puxinmao/ascend310b-object-tracking/中期检查报告.md

# 目标跟踪检测系统 — 中期检查报告

**项目名称**：基于昇腾 310B 与 STM32 的目标跟踪检测系统  
**检查日期**：2026-07-06  
**文档版本**：V1.0  
**提交小组**：第二组（哈基米南北绿豆）  

---

## 一、物料到位总览

### 1.1 已到位物料清单

| 序号 | 物料名称 | 规格/型号 | 数量 | 状态 | 用途 |
|:---:|:---|:---|:---:|:---:|:---|
| 1 | 昇腾 310B 开发板 | Atlas 200 DK | 1 | ✅ 已到位 | 核心算力平台，运行人物检测算法 |
| 2 | 摄像头 | USB 摄像头 | 1 | ✅ 已到位 | 图像采集 |
| 3 | 舵机 | SG90 / MG996R | 2 | ✅ 已到位 | 控制摄像头水平（Pan）和垂直（Tilt）转动 |
| 4 | STM32F103C8T6 | 最小系统板 | 1 | ✅ 已到位 | 舵机控制 MCU |
| 5 | ST-Link 调试器 | V2 版本 | 1 | ✅ 已到位 | STM32 程序烧录与调试 |
| 6 | USB 转 TTL 模块 | CH340G | 1 | ✅ 已到位 | 昇腾与 STM32 串口通信 |
| 7 | 云台支架 | 二自由度云台 | 1 | ✅ 已到位 | 承载摄像头，水平+垂直双轴 |
| 8 | 面包板 + 杜邦线 | 若干 | 1 套 | ✅ 已到位 | 电路连接 |
| 9 | 外部 5V 电源 | 适配器 / 充电宝 | 1 | ✅ 已到位 | 舵机独立供电 |

### 1.2 未到货物料

所有物料均已到位，暂无未到货物项。

---

## 二、当前完成进度

### 2.1 已完成工作

| 序号 | 工作项 | 完成日期 | 说明 |
|:---:|:---|:---:|:---|
| 1 | 物料采购与核对 | 前期 | 全部物料到位并核对完毕 |
| 2 | 昇腾 310B 开发板环境搭建 | 前期 | 开发板上电运行，操作系统 / 开发环境就绪 |
| 3 | 摄像头图像采集 | 前期 | 摄像头连接昇腾成功，能实时获取画面 |
| 4 | 昇腾端人物位置检测与串口输出 | 前期 | 能检测人物在画面中的水平位置，通过串口输出 0x00~0xB4（对应 0°~180°） |
| 5 | STM32 PWM 舵机驱动 | 前期 | STM32 输出 50Hz PWM 信号，成功控制舵机 0°~180° 范围旋转 |
| 6 | STM32 串口中断接收（环形缓冲区） | 前期 | 使用 UART 中断 + 环形缓冲区，稳定接收昇腾端实时数据 |
| 7 | 昇腾 ↔ STM32 串口联调 | 中期 | 两者串口通信调试通过，数据可稳定传输 |
| 8 | 闭环跟踪功能（水平方向） | ✅ **已完成** | 人物水平移动时舵机自动跟随，使人物始终位于画面中央 |
| 9 | 闭环跟踪功能（垂直方向） | ✅ **已完成** | 人物垂直移动时舵机自动跟随，实现二维云台跟踪 |
| 10 | 二维云台联调 | ✅ **已完成** | 水平+垂直两轴协同工作，全方向稳定跟踪 |

### 2.2 进行中工作

| 序号 | 工作项 | 当前状态 | 计划完成 |
|:---:|:---|:---|:---:|
| 1 | 跟踪参数微调 | 对两轴 P 控制参数进行最终优化中 | 验收前 |
| 2 | 系统全面测试 | 不同角度，宽度和距离下的跟踪效果测试 | 验收前 |

### 2.3 未开始工作

当前核心功能已实现，暂无未开始的关键工作项。

---

## 三、硬件调试情况

### 3.1 硬件接线方案

```
                          ┌─────────────────────┐
                          │    外部 5V 电源       │
                          │  (舵机独立供电)        │
                          └──────────┬──────────┘
                                     │
    ┌──────────┐      ┌──────────┐   │  +5V
    │ 昇腾 310B │ USB  │ USB-TTL  │───┤
    │  + 摄像头  │ ←──→│  CH340   │   │  GND ──────┐
    │          │      │ TXD→PA10 │   │            │
    └──────────┘      │ GND──GND │   │            │
                      └──────────┘   │            │
                                     │            │
                              ┌──────▼────┐      │
                              │ STM32F103 │      │
                              │ C8T6      │      │
                              │           │      │
                              │ PA0 ──── 舵机 1（水平 Pan）   │
                              │ PA1 ──── 舵机 2（垂直 Tilt） │
                              │ GND ──────┼──────┘
                              └───────────┘
                                     │
                              ┌──────┬──────┐
                              │ 舵机1 │ 舵机2│
                              │ 水平  │ 垂直 │
                              │ Pan   │ Tilt │
                              └──────┴──────┘
```

**引脚分配表：**

| STM32 引脚 | 功能 | 连接目标 |
|:---|:----|:---|
| PA10 | USART1_RX | USB-TTL TXD（昇腾数据接收） |
| PA9 | USART1_TX | USB-TTL RXD（调试输出，可选） |
| PA0 | TIM2_CH1 PWM | 舵机 1 信号线（水平 Pan） |
| PA1 | TIM2_CH2 PWM | 舵机 2 信号线（垂直 Tilt） |
| GND | 共地 | USB-TTL GND + 舵机电源 GND |

### 3.2 STM32 外设配置

| 外设 | 配置参数 |
|:---|:---|
| RCC | HSE 8MHz → PLL ×9 → SYSCLK = 72MHz |
| USART1 | 115200-8-N-1，RXNE 中断接收 |
| TIM2 | CH1 (PA0): 水平舵机 PWM；CH2 (PA1): 垂直舵机 PWM；50Hz，脉宽 500~2500μs |

### 3.3 调试中遇到的问题与解决措施

#### 问题 1：串口接收响应慢（手动调试时）

- **现象**：PC 串口助手发送数据，舵机等待数秒才开始响应
- **原因**：回调函数中直接读 USART DR 寄存器，HAL 库在进入回调前已读走数据，导致读到无效值
- **解决措施**：改用固定缓存 `rx_byte` 配合 `HAL_UART_Receive_IT()`，回调中从缓存读取，响应恢复正常

#### 问题 2：与昇腾联调时舵机来回摆动

- **现象**：人物在画面最左侧时，舵机向右转→人物回到中央→昇腾发 0x5A→控制逻辑误认为"目标 90°"又重新回位→来回振荡
- **原因**：测试模式下使用"串口值 = 舵机角度"的直接映射，而昇腾发来的是"人物在画面中的位置"，两者含义不同
- **解决措施**：切换为跟踪模式（误差控制），计算 `误差 = 人物位置 - 画面中央`，误差为 0 时舵机保持不动

#### 问题 3：昇腾与 STM32 坐标系不一致

- **现象**：人物在画面左侧时舵机反而向右转，跟踪方向完全相反
- **原因**：昇腾端的坐标系定义与 STM32 端预期方向不一致
- **解决措施**：在 `Control_Compute` 中将误差取反，匹配昇腾坐标系方向（`adjustment = -KP * error`），跟踪方向恢复正常

---

## 四、软件调试情况

### 4.1 昇腾 310B 端功能

| 功能模块 | 开发进度 | 说明 |
|:---|:---:|:----|
| 摄像头图像采集 | ✅ 已完成 | 实时获取视频帧 |
| 人物目标检测 | ✅ 已完成 | 检测画面中人物的水平位置和垂直位置 |
| 位置 → 串口值映射 | ✅ 已完成 | 映射关系：0x00~0xB4 对应 0°~180°，字节值即角度值 |
| 串口数据发送 | ✅ 已完成 | 通过 UART 将位置值发送至 STM32 |

### 4.2 STM32 端功能

| 功能模块 | 开发进度 | 说明 |
|:---|:---:|:----|
| 系统时钟初始化（72MHz） | ✅ 已完成 | HSE+PLL 配置 |
| USART1 中断接收 | ✅ 已完成 | 环形缓冲区，接收中断触发 |
| TIM2 PWM 输出 | ✅ 已完成 | 50Hz，500~2500μs |
| 舵机控制函数 | ✅ 已完成 | `Servo_SetPulse` / `Servo_PulseToAngle` |
| 跟踪控制算法 | ✅ 已完成 | P 控制 + 死区 ±2° + 步进限幅 ±15° |
| 测试模式（PC 串口调试） | ✅ 已完成 | 发多少转多少，一步到位 |
| 跟踪模式（接昇腾使用） | ✅ 已完成 | 误差驱动，自动追人 |
| 模式切换 | ✅ 已完成 | 通过宏 `MODE_SERIAL_TEST` 一键切换 |

### 4.3 核心控制算法

```c
/* 误差 = 人物位置 - 画面中央(90°) */
float error = target_angle - SERVO_CENTER_ANGLE;

/* 死区：误差小于 2° 不动作，防抖动 */
if (fabsf(error) > DEADBAND_ANGLE)
{
    float adjustment = KP * error;                  /* 比例控制 */
    if (adjustment >  MAX_STEP_ANGLE)  adjustment =  MAX_STEP_ANGLE;  /* 限幅 */
    if (adjustment < -MAX_STEP_ANGLE)  adjustment = -MAX_STEP_ANGLE;

    float new_angle = current_angle + adjustment;   /* 更新角度 */
    uint16_t new_pulse = 500 + new_angle * 2000/180; /* 角度 → 脉宽 */
    Servo_SetPulse(new_pulse);
}
/* 误差 < 2°：舵机保持不动 → 人物在画面中央 → 系统稳定 */
```

### 4.4 已通过的测试用例

| 测试用例 | 测试方法 | 结果 |
|:---|:---|:---:|
| 舵机全量程测试 | PC 串口助手发送 0x00~0xB4，观察舵机 0°~180° 旋转 | ✅ 通过 |
| 串口数据接收 | PC 连续发送数据，STM32 环形缓冲区无丢包 | ✅ 通过 |
| 昇腾→STM32 通信 | 昇腾串口直连 STM32，数据传输稳定 | ✅ 通过 |
| 跟踪方向正确性 | 人物左右移动，舵机跟随方向正确 | ✅ 通过（修正后）|
| 人物静止时稳定性 | 人物在摄像头前静止，舵机无异常摆动 | ✅ 通过 |
| 人物水平走动跟踪 | 人物在画面内左右走动，舵机平滑跟随 | ✅ 通过 |
| 人物垂直移动跟踪 | 人物上下移动时，垂直舵机正常跟随 | ✅ 通过 |
| 二维联合跟踪 | 人物对角线方向移动，两轴协同工作 | ✅ 通过 |

---

## 五、存在的问题与风险

### 5.1 当前问题

| 问题 | 描述 | 影响 | 应对方案 |
|:----|:----|:----|:---|
| 水平/垂直参数未独立标定 | 两轴物理特性不同，共用参数影响效果 | 垂直方向响应可进一步优化 | 分别为 Pan 和 Tilt 配置独立的 KP/死区/限步参数 |
| 舵机转速限制 | 普通舵机转速约 60°/0.12s | 人物快速移动时可能有滞后 | 可调整控制参数或更换高速舵机 |

### 5.2 潜在风险

| 风险项 | 可能性 | 影响程度 | 预防/应对措施 |
|:---|:---:|:---:|:---|
| 光线变化影响人物检测 | 中 | 中 | 加强昇腾端检测算法的鲁棒性 |
| 串口传输受到干扰 | 低 | 高 | 使用屏蔽线、缩短传输距离、添加数据校验 |
| 舵机长时间运行过热 | 低 | 低 | 避免长时间连续高强度跟踪，适当休息 |
| 电源供电不稳定 | 低 | 中 | 舵机和 STM32 分别供电，做好滤波 |

### 5.3 物料延期风险

所有物料已到位，无物料延期风险。

---

## 六、后续工作计划

### 6.1 至验收前的详细计划

| 阶段 | 时间 | 工作内容 | 交付物 |
|:---|:---:|:---|:---|
| **参数调优** | 检查后 ~3 天 | 在真实场景下调试跟踪平滑度和响应速度，调整 KP/死区/限步幅 | 稳定运行的跟踪系统 |
| **系统测试** | ~2 天 | 多场景测试（不同光照、不同距离、单人/多人） | 测试记录 |
| **问题修复** | ~2 天 | 修复测试发现的问题 | Bug 修复记录 |
| **文档完善** | ~2 天 | 补充硬件原理图、参数表、操作说明 | 完整的技术文档 |
| **验收准备** | 最后 1 天 | 整理所有物料、演示准备、验收材料整理 | 验收演示 |

### 6.2 后续功能扩展计划

- **PID 控制**：在 P 控制基础上引入积分项和微分项，进一步提升跟踪精度和稳定性
- **自适应参数**：根据人物移动速度自动调整控制参数，适应不同场景

---

## 七、附录

### A. 关键参数表

| 参数 | 值 | 说明 |
|:----|:---|:-----|
| STM32 系统时钟 | 72 MHz | HSE 8MHz × PLL 9 |
| PWM 频率 | 50 Hz | T: 20ms |
| PWM 脉宽范围 | 500~2500 μs | 对应 0°~180° |
| 舵机中位脉宽 | 1500 μs | 对应 90° |
| UART 波特率 | 115200 | 昇腾 ↔ STM32 |
| 比例系数 KP | 0.6 | 可调 |
| 死区角度 | ±2° | 可调 |
| 最大步进角度 | ±15°/次 | 可调 |
| 串口值范围 | 0x00~0xB4 | 对应 0°~180° |

---

> **报告日期**：2026-07-06  
> **当前状态**：核心跟踪功能已完成，处于参数调优与稳定性测试阶段  
> **预计验收日期**：2026 年 7 月 9 日
