puxinmao/ascend310b-object-tracking/系统设计文档.md

# 目标跟踪检测系统设计文档

---

## 目录

1. [物料到位情况](#1-物料到位情况)
2. [系统方案设计](#2-系统方案设计)
3. [详细设计文档](#3-详细设计文档)
4. [进度汇报](#4-进度汇报)

---

## 1. 物料到位情况

### 1.1 已到货物料清单与实物核对

| 序号 | 物料名称 | 规格/型号 | 数量 | 核对结果 | 备注 |
|:---:|:---|:---|:---:|:---|:---|
| 1 | 昇腾 310B 开发板 | —（待补充具体型号） | 1 | ✅ 已到位 | 核心算力平台 |
| 2 | 摄像头 | —（待补充具体型号/接口） | 1 | ✅ 已到位 | 图像采集 |
| 3 | 舵机 | —（待补充具体型号） | 1（或2，待确认） | ✅ 已到位 | 云台角度控制 |
| 4 | STM32F103C8T6 | STM32 最小系统板 | 1 | ✅ 已到位 | 舵机控制 MCU |
| 5 | ST-Link | ST-Link 调试器 | 1 | ✅ 已到位 | 程序烧录与调试 |
| 6 | 传输线 | —（待补充具体线材类型） | 若干 | ✅ 已到位 | 电路连接 |
| 7 | USB 转 TTL 接口 | —（待补充具体芯片型号） | 1（或2，待确认） | ✅ 已到位 | 昇腾与 STM32 串口通信 |

**核对结论**：全部物料已到位，实物与清单一致，可以进入系统联调阶段。

### 1.2 未到货物料

当前所有物料均已到位，无未到货物项。

---

## 2. 系统方案设计

### 2.1 系统总体架构

本系统实现 **基于视觉的目标跟踪**，整体采用 **昇腾 310B + STM32F103** 的主从双处理器架构：

```
 ┌───────────────────────────────────────────────────────────┐
 │                    系统总体架构                            │
 │                                                           │
 │  ┌────────────────────────┐   UART    ┌───────────────┐  │
 │  │    昇腾 310B 开发板     │ ←───────→ │ STM32F103C8T6 │  │
 │  │  (读取人物位置串口信息) │  串口通信  │  (控制舵机)    │  │
 │  │                        │           │               │  │
 │  │     ┌──────────┐       │           │   ┌────────┐  │  │
 │  │     │  摄像头   │       │           │   │  舵机  │  │  │
 │  │     └──────────┘       │           │   └────────┘  │  │
 │  └────────────────────────┘           └───────────────┘  │
 │                                                           │
 └───────────────────────────────────────────────────────────┘
```

**系统工作方式说明**（基于已有信息）：

1. 昇腾 310B 开发板连接摄像头，不断读取视频画面中人物的串口信息（位置数据）
2. 昇腾 310B 通过串口将人物位置数据发送给 STM32F103C8T6
3. STM32 根据接收到的位置信息控制舵机转动
4. **控制目标**：使捕捉到的人物的串口值始终保持不变，即让人物始终位于摄像头的画面中央

> **注**：人物检测的具体算法（如 AI 模型类型、传统视觉方法等）及串口通信的协议格式，需由项目实际实现确定，此处暂不假定。

### 2.2 硬件框图（待补充）

> **说明**：实际硬件连接方式（各芯片间具体引脚连接、供电方式、舵机与 STM32 的连接引脚等）需根据所选开发板型号、舵机型号及实际电路设计确定，此处暂空缺。

```
                    ┌───────────────────┐
                    │     摄像头         │
                    └────────┬──────────┘
                             │ （接口类型待确认）
                             ▼
                   ┌───────────────────┐
                   │   昇腾 310B 开发板  │
                   │                   │
                   │   UART TX/RX      │──────────── 串口通信
                   └───────────────────┘
                             │
                      USB 转 TTL 模块
                             │
                             ▼
                   ┌───────────────────┐
                   │   STM32F103C8T6    │
                   │   UART 接收        │
                   │   PWM 输出         │──────────── 舵机控制
                   └───────────────────┘
                             │
                             ▼
                   ┌───────────────────┐
                   │      舵机          │
                   └───────────────────┘
```

**待确认项**：
- 昇腾 310B 与 STM32 之间串口连接的具体引脚
- 舵机与 STM32 的 PWM 控制引脚
- 系统的供电方案（各模块供电电压、电源管理方式）
- 舵机数量及对应的自由度数（水平 / 俯仰）

### 2.3 软件流程图（待细化）

> **说明**：以下为基于现有信息的逻辑示意，具体实现（使用何种框架、算法、编程语言等）需根据实际项目确定。

#### 2.3.1 昇腾 310B 端软件流程

```
 ┌──────────────────────────┐
 │        系统启动            │
 └───────────┬──────────────┘
             ▼
 ┌──────────────────────────┐
 │    初始化摄像头            │
 │    初始化串口              │
 └───────────┬──────────────┘
             ▼
      ╔══════════════════╗
      ║     主循环        ║
      ╚══════════════════╝
             ▼
 ┌──────────────────────────┐
 │    采集一帧图像            │
 └───────────┬──────────────┘
             ▼
 ┌──────────────────────────┐
 │    检测人物位置            │
 │  （检测方法待确定）         │
 └───────────┬──────────────┘
             ▼
 ┌──────────────────────────┐
 │    计算人物位置串口值      │
 │    （偏移量等）            │
 └───────────┬──────────────┘
             ▼
 ┌──────────────────────────┐
 │    通过 UART 发送数据      │
 │    到 STM32              │
 └───────────┬──────────────┘
             ▼
            继续循环
```

#### 2.3.2 STM32 端软件流程

```
 ┌──────────────────────────┐
 │        系统启动            │
 │    系统时钟初始化           │
 │    GPIO / UART / TIM 初始化│
 └───────────┬──────────────┘
             ▼
 ┌──────────────────────────┐
 │      舵机复位（归中位）     │
 └───────────┬──────────────┘
             ▼
      ╔══════════════════╗
      ║     主循环        ║
      ╚══════════════════╝
             ▼
 ┌──────────────────────────┐
 │   UART 接收昇腾发来的数据   │
 │   (人物位置串口值)          │
 └───────────┬──────────────┘
             ▼
 ┌──────────────────────────┐
 │   根据位置值计算舵机角度    │
 │   (控制算法待确定)         │
 └───────────┬──────────────┘
             ▼
 ┌──────────────────────────┐
 │   输出 PWM 控制舵机转动    │
 │   (使人物保持在画面中央)    │
 └───────────┬──────────────┘
             ▼
            继续循环
```

---

## 3. 详细设计文档

### 3.1 硬件部分

#### 3.1.1 电路原理图

> **待补充**：实际电路原理图需根据所选用的具体硬件型号（昇腾 310B 开发板的引脚定义、STM32F103C8T6 的引脚分配、舵机接口定义）以及实际接线方式绘制。当前阶段建议使用实物接线图或手绘示意图暂代，后续完善正式原理图。

**关键连接示意（待确认）**：

```
昇腾 310B <───USB转TTL───> STM32F103C8T6
                              │
                              ├── PWM ────> 舵机（信号线）
                              │
                             GND ────> 舵机 GND（共地）
```

#### 3.1.2 关键元件参数计算

> **待补充**：以下参数需根据实际选型确定。

| 参数 | 说明 | 状态 |
|:---|:---|:---:|
| 舵机工作电压/电流 | 根据所选舵机型号确定 | 待确认 |
| 舵机 PWM 信号频率与脉宽范围 | 根据舵机数据手册确定 | 待确认 |
| STM32 系统时钟频率 | 通常为 HSE 晶振频率经 PLL 倍频 | 待确认 |
| UART 波特率 | 昇腾与 STM32 通信速率 | 待确认 |
| 舵机控制算法参数 | PID 或其他控制算法参数需调试确定 | 待确认 |
| 供电方案 | 各模块电压、电流需求及电源分配 | 待确认 |

#### 3.1.3 PCB 布局规划

> **说明**：当前阶段使用 **STM32 最小系统板 + 杜邦线/传输线** 搭建原型验证，暂不设计专用 PCB。后续如有需要，可根据实际电路设计 PCB。

---

### 3.2 软件部分

#### 3.2.1 模块划分

> **待细化**：以下为建议性模块划分，具体模块名称、文件组织方式需根据实际开发情况确定。

##### 昇腾 310B 端

| 模块 | 建议功能描述 | 说明 |
|:---|:---|:---|
| 主控模块 | 系统初始化，主循环调度 | 具体实现待确定 |
| 摄像头采集模块 | 图像帧采集 | 接口实现待确定 |
| 人物检测模块 | 检测画面中人物位置 | 算法待确定 |
| 坐标/串口值计算模块 | 计算人物位置的串口输出值 | 具体计算方式待确定 |
| 串口通信模块 | 向 STM32 发送数据 | 协议格式待确定 |

##### STM32 端

| 模块 | 建议功能描述 | 说明 |
|:---|:---|:---|
| 主控模块 | 系统初始化，主循环调度 | 待实现 |
| UART 接收模块 | 接收昇腾发来的串口数据 | 协议格式待确定 |
| 舵机控制模块 | 根据位置数据控制舵机转动 | 控制算法待确定 |
| PWM 驱动模块 | 输出 PWM 信号驱动舵机 | 参数待确定 |

#### 3.2.2 关键算法描述

> **待补充**：以下算法需根据实际项目需求和技术选型确定。

**（1）人物检测算法（昇腾 310B 端）**

- 具体采用何种检测方法，需根据昇腾 310B 开发板上实际可用的框架和模型确定
- 可能方向：基于 AI 的目标检测模型（如 YOLO 系列等），或传统视觉方法（如颜色识别、轮廓检测等）
- 昇腾 310B 支持 Ascend AI 推理框架，具体使用的推理引擎需根据实际部署方案确定

**（2）人物位置与串口值的映射关系**

- 昇腾 310B 计算出的人物位置如何映射为串口输出值（偏移量？角度值？），需由具体协议定义

**（3）舵机控制算法（STM32 端）**

- STM32 端如何根据串口接收到的位置数据计算舵机目标角度
- 可能的控制方式：比例控制、PID 控制等，具体方案待项目实现时确定
- 需考虑：响应速度、稳定性、防抖处理

#### 3.2.3 外设配置方案

> **待补充**：以下配置需在 STM32 端代码实现时根据实际硬件连接确定。

**STM32 外设配置（待确认）**：

| 外设 | 用途 | 配置参数 | 状态 |
|:---|:---|:---|:---:|
| RCC | 系统时钟 | 待确定 | 待确认 |
| UART | 接收昇腾数据 | 波特率、引脚等待确定 | 待确认 |
| TIM / PWM | 舵机控制 | 频率、占空比范围待确定 | 待确认 |
| GPIO | 状态指示等（如有需要） | 引脚用途待确定 | 待确认 |

#### 3.2.4 任务调度设计（FreeRTOS 任务划分）

> **说明**：STM32F103C8T6 上是否使用 FreeRTOS，需根据项目实际需求确定。如果系统逻辑简单（如仅在主循环中轮询串口接收 + 更新舵机），则可以不使用操作系统。

**如果采用 FreeRTOS，建议任务划分如下（待细化）**：

| 任务名称 | 优先级 | 功能描述 | 说明 |
|:---|:---:|:---|:---|
| UART 数据处理任务 | 最高 | 解析串口接收数据，提取人物位置信息 | 可由中断+信号量触发 |
| 舵机控制任务 | 中 | 根据位置数据计算目标角度，更新 PWM | 可由消息队列传递角度值 |
| 状态指示任务（可选） | 低 | 指示灯、调试信息输出等 | 辅助功能 |

> **注**：以上任务划分仅为建议，实际是否需要多任务、任务间如何通信，需根据系统复杂度确定。

---

## 4. 进度汇报

### 4.1 当前完成情况

| 序号 | 工作项 | 状态 | 说明 |
|:---:|:---|:---:|:---|
| 1 | 物料采购与核对 | ✅ 已完成 | 所有物料已到位并核对完毕 |
| 2 | 昇腾 310B 开发板环境搭建 | ✅ 已完成 | 开发板已上电运行，基本环境就绪 |
| 3 | 摄像头画面采集与人物位置输出 | ✅ 已完成 | 摄像头能根据人物位置变化，输出对应的串口值 |
| 4 | STM32 控制舵机复位 | ✅ 已完成 | STM32 能够输出 PWM 信号，控制舵机回到复位位置 |
| 5 | 昇腾与 STM32 串口联调 | ⏳ 未开始 / 进行中 | 待确认当前进度 |
| 6 | 闭环跟踪功能（摄像头随动） | ⏳ 未开始 | 核心功能——STM32 根据串口值实时控制舵机旋转，使人物保持在画面中央 |

### 4.2 后续工作计划

> **说明**：以下计划为建议性安排，具体时间节点需根据项目实际进度调整。

| 阶段 | 工作内容 | 目标 |
|:---|:---|:---|
| **第一阶段** | 昇腾 310B 与 STM32 串口通信联调 | 确保数据稳定传输，协议明确 |
| **第二阶段** | STM32 端舵机随动控制实现 | 根据接收到的位置数据实时调整舵机角度，形成闭环 |
| **第三阶段** | 系统整体联调与优化 | 跟踪效果测试，稳定性优化，参数调优 |
| **第四阶段** | 文档完善与验收 | 补齐各章节内容，整理测试报告 |

### 4.3 需进一步确认的事项

| 序号 | 事项 | 说明 |
|:---:|:---|:---|
| 1 | 舵机具体型号与数量 | 影响 PWM 参数和控制方式 |
| 2 | 摄像头具体型号与接口 | 影响图像采集方式 |
| 3 | 昇腾 310B 开发板具体型号 | Atlas 200 DK 或其他版本，影响引脚定义和开发环境 |
| 4 | 人物检测的具体实现方式 | AI 模型还是传统方法 |
| 5 | 串口通信协议格式 | 数据帧定义、校验方式等 |
| 6 | 是否使用 FreeRTOS | 决定任务调度方式 |
| 7 | 舵机控制算法 | PID 参数或其他控制策略需调试确定 |

---

> **文档版本**：V2.0  
> **创建日期**：2025-01-09  
> **项目名称**：目标跟踪检测系统
