puxinmao/ascend310b-object-tracking/项目计划书.md

# 项目计划书：基于昇腾310B的目标跟踪检测系统

> **选题**：题目4：昇腾310B目标跟踪检测  
> **小组成员**：吴铭帆、梁乐天、张泽滨  
> **提交日期**：2026-06-30  

---

## 一、项目概述

本项目基于 **昇腾310B（OrangePi AIpro）** 开发板，利用 **MobileNet-SSD** 轻量级检测模型在 NPU 上进行实时目标检测，结合 **DeepSORT** 跟踪算法（卡尔曼滤波 + 匈牙利算法）实现多目标轨迹追踪。检测与跟踪结果通过串口发送至 **STM32F103C8T6**，驱动二轴舵机云台随目标转动，使目标始终保持在画面中心区域。

本项目为**二次开发**性质——开发环境（CANN 8.0）已由小组成员搭建完成，基础代码（检测推理与跟踪框架）已由老师提供并烧录至开发板。

开发策略采用**分阶段推进**：

> **第一阶段（优先级高）**：集中精力把基础的**检测+跟踪**跑通、调稳，确保跟踪 ID 稳定、轨迹连续，达到中等到良好的考核标准。
> **第二阶段（锦上添花）**：在基础功能稳固的前提下，再推进 STM32 舵机云台控制，冲击优秀。

---

## 二、工作计划（时间节点与里程碑）

### 2.1 已完成工作

| 工作项 | 完成时间 | 说明 |
|---|---|---|
| ✅ 环境搭建（CANN 8.0） | 已完成 | 昇腾310B CANN 8.0 环境配置完毕，Python依赖安装完毕 |
| ✅ 基础代码获取与烧录 | 已完成 | 老师提供的 detection + tracking 框架代码已烧录至开发板 |
| ✅ 硬件到位 | 已完成 | 昇腾310B、STM32、摄像头、舵机×2、云台、ST-Link、串口线、HDMI线、SD卡等全部到位 |
| ✅ 选题与分组 | 2026-06-29 | 确定题目4，完成三人分工 |

### 2.2 后续工作计划

| 阶段 | 起止时间 | 里程碑 / 交付物 | 主要负责人 |
|---|---|---|---|
| **第一阶段：检测+跟踪（基础）** | | 优先级最高，先确保检测跟踪跑通调稳 | |
| ├ 代码理解 | 2026-06-30 ~ 2026-07-01 | 跑通 detection_app.py / tracking_app.py，理清全链路流程 | 吴铭帆、梁乐天、张泽滨（三人一起） |
| ├ 检测调优 | 2026-07-01 | 调整置信度/NMS阈值，验证不同场景检测效果 | 吴铭帆（梁乐天协助） |
| ├ 跟踪调优 | 2026-07-01 ~ 2026-07-02 | DeepSORT参数调优：卡尔曼滤波、max_age、IOU匹配阈值 | 梁乐天（吴铭帆协助） |
| ├ 基础验证 | 2026-07-02 上午 | 确认跟踪ID稳定、轨迹连续，达到可演示状态 | 全体 |
| **提交设计文档** | 2026-07-02 9:00 | 提交《系统设计文档》并分组汇报 | 全体 |
| **中期检查** | 2026-07-06 15:00 | 提交《中期检查报告》，进度检查、问题排查 | 全体 |
| **第二阶段：STM32云台（扩展）** | | 基础调稳后再推进 | |
| ├ STM32云台开发 | 2026-07-02 ~ 2026-07-04 | 串口接收坐标、SG90舵机PWM驱动、二轴PID控制 | 张泽滨 |
| ├ 全链路联调 | 2026-07-04 ~ 2026-07-06 | 检测-跟踪-串口-云台集成，延迟优化 | 全体 |
| **功能完善与优化** | 2026-07-06 ~ 2026-07-08 | 跟踪ID稳定性再优化、云台流畅度调优、边界情况处理 | 全体 |
| **第一次验收** | 2026-07-09 9:00 | 分组演示系统功能，现场测试 | 全体 |
| **改进与第二次验收** | 2026-07-09 ~ 2026-07-10 | 根据验收意见改进，最终验收 | 全体 |
| **个人总结报告** | 验收后一周内 | 每位成员独立提交个人总结报告（LaTeX模板） | 各自 |

---

## 三、时间安排与分工方案

### 3.1 成员可投入时间

| 成员 | 可投入时间 | 第一阶段职责（6/30~7/2） | 第二阶段职责（7/2~） |
|---|---|---|---|
| **吴铭帆** | 每日3~4小时 | 昇腾端代码理解、检测推理调试、NPU推理参数调优 | 系统联调、整机优化 |
| **梁乐天** | 每日3~4小时 | DeepSORT跟踪算法调试、跟踪ID稳定性优化、参数调优 | 系统联调、答辩准备 |
| **张泽滨** | 每日3~4小时 | **先参与代码理解与测试**，协助昇腾端调试 | 转做STM32云台开发（串口/PWM/PID） |

### 3.2 两阶段分工方案

#### 第一阶段（6/30 ~ 7/2）：聚焦检测+跟踪基础功能

| 工作模块 | 具体内容 | 主要负责人 | 协作 |
|---|---|---|---|
| **代码理解** | 三人一起阅读 detection_app.py / tracking_app.py，理清预处理→NPU推理→解码→NMS→跟踪全链路 | 吴铭帆、梁乐天、张泽滨 | 三人结对研读，互相讲解 |
| **检测调优** | 调整检测置信度阈值、NMS的IOU阈值、验证不同光照/距离下的检测效果 | 吴铭帆 | 梁乐天、张泽滨协助采集测试数据 |
| **跟踪调优** | DeepSORT参数调优：卡尔曼滤波过程噪声/观测噪声、max_age、min_hits、IOU匹配阈值 | 梁乐天 | 吴铭帆协助联调 |
| **基础验证** | 确认目标检测准确、跟踪ID稳定、轨迹连续，记录当前FPS与ID切换次数作为基线 | 全体 | 集体验收 |
| **文档撰写** | 设计文档初稿（系统架构、检测跟踪原理、二次开发说明） | 三人分章节 | 全体校对 |

#### 第二阶段（7/2 ~ 7/6）：STM32云台扩展 + 全链路联调

| 工作模块 | 具体内容 | 主要负责人 | 协作 |
|---|---|---|---|
| **STM32云台** | 串口通信协议定义、SG90舵机PWM驱动、二轴PID控制算法、ST-Link调试 | 张泽滨 | 吴铭帆协助协议对齐 |
| **系统联调** | 检测-跟踪-串口-云台全链路集成、响应延迟优化 | 全体 | 集体攻关 |
| **文档完善** | 补充云台控制部分、中期报告 | 三人分章节 | 全体校对 |
| **演示准备** | 功能演示视频录制、PPT制作、现场答辩 | 全体 | 集体准备 |

---

## 四、物料清单（已全部到位）

### 4.1 现有物料

| 序号 | 物料名称 | 型号/规格 | 数量 | 状态 |
|---|---|---|---|---|
| 1 | AI开发板 | OrangePi AIpro（昇腾310B） | 1 | ✅ 已到位 |
| 2 | 辅助MCU | STM32F103C8T6最小系统板 | 1 | ✅ 已到位 |
| 3 | USB摄像头 | 支持640×480及以上 | 1 | ✅ 已到位 |
| 4 | 舵机 | SG90 180°（二轴云台用） | 2 | ✅ 已到位 |
| 5 | 二轴云台支架 | 两自由度云台 | 1 | ✅ 已到位 |
| 6 | 调试器 | ST-Link | 1 | ✅ 已到位 |
| 7 | 串口线 | USB转TTL（CH340G） | 1 | ✅ 已到位 |
| 8 | 显示器连接线 | HDMI线 | 1 | ✅ 已到位 |
| 9 | 存储卡 | MicroSD卡 32GB+ Class10 | 1 | ✅ 已到位 |
| 10 | 开发板电源 | 5V/2A Type-C适配器 | 1 | ✅ 已到位 |

> ✅ **全部物料已到位，无需额外采购。**

---

## 五、技术方案概要

### 5.1 系统架构

```
┌─────────────────────────────────────────────────┐
│                  OrangePi AIpro                  │
│  ┌──────────┐   ┌──────────┐   ┌─────────────┐  │
│  │ USB Camera│──▶│MobileNet │──▶│  DeepSORT   │  │
│  │ (视频流)  │   │ -SSD NPU │   │  跟踪器     │  │
│  └──────────┘   │  推理    │   │ (卡尔曼+    │  │
│                 └──────────┘   │  匈牙利)    │  │
│                               └──────┬──────┘  │
│                                      │ 串口     │
│                                      ▼  (目标坐标)│
└──────────────────────────────────┬──────────────┘
                                   │ UART-TTL
┌──────────────────────────────────▼──────────────┐
│                 STM32F103C8T6                    │
│  ┌────────────┐   ┌──────────┐   ┌───────────┐  │
│  │ 串口接收   │──▶│ PID计算  │──▶│ PWM输出   │  │
│  │ (目标坐标) │   │ (偏差→   │   │ (舵机驱动)│  │
│  └────────────┘   │  控制量) │   └─────┬─────┘  │
│                   └──────────┘         │         │
└────────────────────────────────────────┼─────────┘
                                         ▼
                               ┌─────────────────┐
                               │  二轴舵机云台    │
                               │  (SG90 ×2)      │
                               │  水平 + 俯仰    │
                               └─────────────────┘
```

### 5.2 软件栈

| 组件 | 技术选型 |
|---|---|
| AI推理框架 | **CANN 8.0** + PyACL |
| 目标检测模型 | MobileNet-SSD（OM格式，老师已提供） |
| 目标跟踪算法 | DeepSORT（卡尔曼滤波 + 匈牙利匹配） |
| 编程语言 | Python 3.9+（昇腾端）、C（STM32端） |
| 计算机视觉 | OpenCV 4.8+ |
| 科学计算 | NumPy、SciPy |
| 串口通信 | Python `pyserial` / STM32 USART |
| MCU开发 | Keil MDK / STM32CubeIDE + HAL库 |
| 调试工具 | ST-Link、串口调试助手 |
| 版本管理 | Git + GitHub |

### 5.3 二次开发工作内容（分阶段推进）

#### 第一阶段（优先级高）：检测+跟踪基础功能

> **目标**：跑通并调稳检测+跟踪链路，确保单帧检测准确、连续帧跟踪ID稳定。

**步骤1：三人共同理解代码（6/30）**

1. 吴铭帆主讲 `detection_app.py`：图像预处理（resize、normalize）→ 加载OM模型 → NPU推理 → 结果解码 → NMS
2. 梁乐天主（参）讲 `tracking_app.py`：卡尔曼滤波预测、IOU 矩阵计算、匈牙利算法匹配、轨迹创建/更新/删除
3. 张泽滨辅助理解串口通信部分：昇腾端串口发送代码、通信协议（帧格式、波特率等）
4. **三人各自跑一遍程序**，记录当前检测效果和跟踪表现

**步骤2：检测调优（吴铭帆，7/1）**

1. 调整 `--score-threshold`（默认0.5，尝试0.3~0.7区间）
2. 调整 `--nms-threshold`（默认0.5，尝试0.4~0.6）
3. 测试不同光照、不同距离下的检测效果
4. 选定最优参数组合

**步骤3：跟踪调优（梁乐天，7/1~7/2）**

1. 调整 `--track-max-age`（轨迹最大丢失帧数，默认30，尝试60/120）
2. 调整 `--track-min-hits`（轨迹最少命中次数，默认3，尝试1/5）
3. 调整 `--track-iou-threshold`（IOU关联阈值，默认0.3，尝试0.4/0.5）
4. 调整 `--track-center-distance-threshold`（中心距离补充匹配阈值）
5. 调整 `--track-size-smoothing` 和 `--track-score-smoothing`（框大小和分数平滑）
6. 测试 `--track-classes person` 只跟踪行人，降低干扰
7. **记录最优参数组合**，确保ID稳定后再进入第二阶段

**步骤4：基础验证（全体，7/2上午）**

1. 在摄像头实时场景下连续运行5分钟以上
2. 统计ID切换次数、跟踪丢失情况
3. 确保达到「可演示」状态

---

#### 第二阶段（锦上添花）：STM32云台控制 + 全链路联调

> **目标**：在基础跟踪稳定的前提下，增加云台随动功能，冲击优秀。

**步骤5：STM32云台控制开发（张泽滨，7/2~7/4）**

1. **硬件连接**
   - SG90 舵机信号线 → STM32 TIM PWM 输出引脚（两路：水平+俯仰）
   - ST-Link → STM32 SWD 调试接口
   - 昇腾310B UART TX → STM32 USART RX（通过 USB转TTL 模块）
2. **PWM驱动**：配置 TIM 产生 50Hz PWM，脉宽 0.5ms~2.5ms 对应 0°~180°
3. **串口接收**：USART 中断接收昇腾310B发送的目标坐标 `(x, y)`
   - 通信协议：帧头(0xAA) + 坐标x + 坐标y + 校验 + 帧尾(0x55)
   - 波特率：115200
4. **PID控制**：以画面中心 `(cx, cy)` 为期望位置，目标坐标偏差为误差输入，输出 PWM 控制量
5. **单独测试**：先用上位机模拟坐标发送，验证舵机响应正确

**步骤6：全链路联调（全体，7/4~7/6）**

1. **协议对齐**：确认昇腾端串口发送格式与 STM32 接收解析一致
2. **闭环测试**：摄像头 → 检测 → 跟踪 → 串口 → STM32 → 舵机云台，完整链路验证
3. **延迟优化**：调整推理帧率、串口波特率、PID 参数整定，减少跟踪滞后
4. **边界测试**：目标快速移动、目标短暂离开画面后重新出现、多目标交叉场景

---

## 六、风险管理

| 风险 | 概率 | 影响 | 应对措施 |
|---|---|---|---|
| 老师提供的代码存在 Bug 或不完整 | 低 | 高 | 小组先全面阅读理解代码，记录疑问向老师确认 |
| 跟踪ID频繁跳变 | 中 | **高** | **第一阶段重点解决**：调整卡尔曼参数、IOU匹配阈值、max_age，使用--track-classes缩小干扰 |
| 基础检测跟踪未调稳就急于做云台 | 中 | 高 | **策略风险**：严格按分阶段推进，基础功能未达标前不进入第二阶段 |
| 云台响应滞后（PID 参数不当） | 中 | 中 | 第二阶段再处理：从保守参数开始，逐步整定 |
| 舵机抖动或过冲 | 中 | 中 | 第二阶段再处理：加入输出限幅、死区控制、低通滤波 |
| 串口通信丢包或数据错位 | 低 | 中 | 第二阶段再处理：增加帧头帧尾校验，超时重传机制 |
| 团队成员时间冲突 | 中 | 中 | 预留缓冲时间，关键节点集体攻关 |

---

## 七、交付清单

| 交付物 | 截止时间 | 说明 |
|---|---|---|
| ✅ 项目计划书（本文件） | 2026-06-30 | 本阶段交付 |
| 📄 系统设计文档 | 2026-07-02 | 含硬件框图、软件流程图、二次开发说明 |
| 📄 中期检查报告 | 2026-07-06 | 进度检查、调试问题与解决措施 |
| 🎥 功能演示视频 | 2026-07-09 | 第一次验收使用 |
| 📄 个人总结报告 | 验收后一周内 | 每人一份，LaTeX模板 |
| 💻 完整代码（含二次开发增量） | 验收时 | GitHub仓库提交 |

---

> **参考资源**
> - 题目参考：[目标跟踪检测](https://zhouxzh.github.io/Ascend310/experiment/case2.html)
> - 完整代码仓库：[Ascend310/samples/case2](https://github.com/zhouxzh/Ascend310/tree/main/samples/case2)
> - detection入口：`scripts/detection_app.py` ｜ tracking入口：`scripts/tracking_app.py`
> - 检测后端：`ssdlite/npu_backend.py`（NPU）｜ `ssdlite/cpu_backend.py`（CPU）
> - 跟踪模块：`tracking/deepsort.py` ｜ `tracking/kalman_filter.py`
> - 昇腾310B开发手册：OrangePi_AI_Pro_昇腾_用户手册_v0.9.2.pdf
> - CANN 8.0 文档：Ascend-cann-toolkit_8.3.RC1
