puxinmao/ascend310b-object-tracking/stm32control/stm32control.ioc

Mcu.UserName=STM32F103C8Tx
PA0-WKUP.Signal=S_TIM2_CH1_ETR
PA1.Signal=S_TIM2_CH2
PA10.Signal=USART1_RX
PA13.Signal=SYS_JTMS-SWDIO
PA14.Signal=SYS_JTCK-SWCLK
PA9.Signal=USART1_TX
PB6.Signal=I2C1_SCL
PB7.Signal=I2C1_SDA
PD0-OSC_IN.Signal=RCC_OSC_IN
PD1-OSC_OUT.Signal=RCC_OSC_OUT
