puxinmao/ascend310b-object-tracking/(commit log)

2026-06-29 chore: init project with 项目计划书 for 昇腾310B目标跟踪检测
2026-06-29 update: 补充真实姓名、CANN 8.0、二次开发背景，更新物料与分工
2026-06-29 add: 项目目标要求.md - 记录题目4考核标准与硬件清单
2026-06-29 update: 重构计划书为两阶段推进——先基础(检测+跟踪)后进阶(STM32云台)
2026-06-29 fix: 删除残留的旧表头和重复标题，修复排版格式
2026-06-30 remove: 项目目标要求.md从GitHub移除，保留本地
2026-06-30 refactor: 迁移仓库根目录到嵌入设课设
2026-06-30 remove: 移除项目目标要求.md（保留本地）
2026-07-01 add: 系统设计文档（硬件/软件/进度汇报）
2026-07-02 feat: 上传case2(检测跟踪代码)和stm32control(舵机云台控制)
2026-07-03 update: case2和stm32control最新修改
2026-07-05 add: 中期检查报告
2026-07-06 update: case2追踪舵机控制 + stm32control主控逻辑优化
2026-07-07 refactor: 优化case2和stm32control代码逻辑
    - tracking_servo_app: 重构跟踪应用逻辑
    - serial_controller: 优化串口控制器
    - serial_monitor: 改进串口监视功能
    - main.c: 优化STM32主控程序控制算法
2026-07-09 更新case2和stm32control代码
    - case2: 优化跟踪应用/串口控制/串口监视 + 新增手势识别(gesture/)
    - stm32control: 更新主控/配置 + 新增OLED驱动(oled)
2026-07-10 add: README、项目图片、个人报告
2026-07-11 update: 个人报告（按学号命名更新）
